MobileFF/usb2joy9/kicad/usb2mdjoy/usb2mdjoy.kicad_sch

## KiCad design kicad/usb2mdjoy/usb2mdjoy.kicad_sch (2026-10-20)

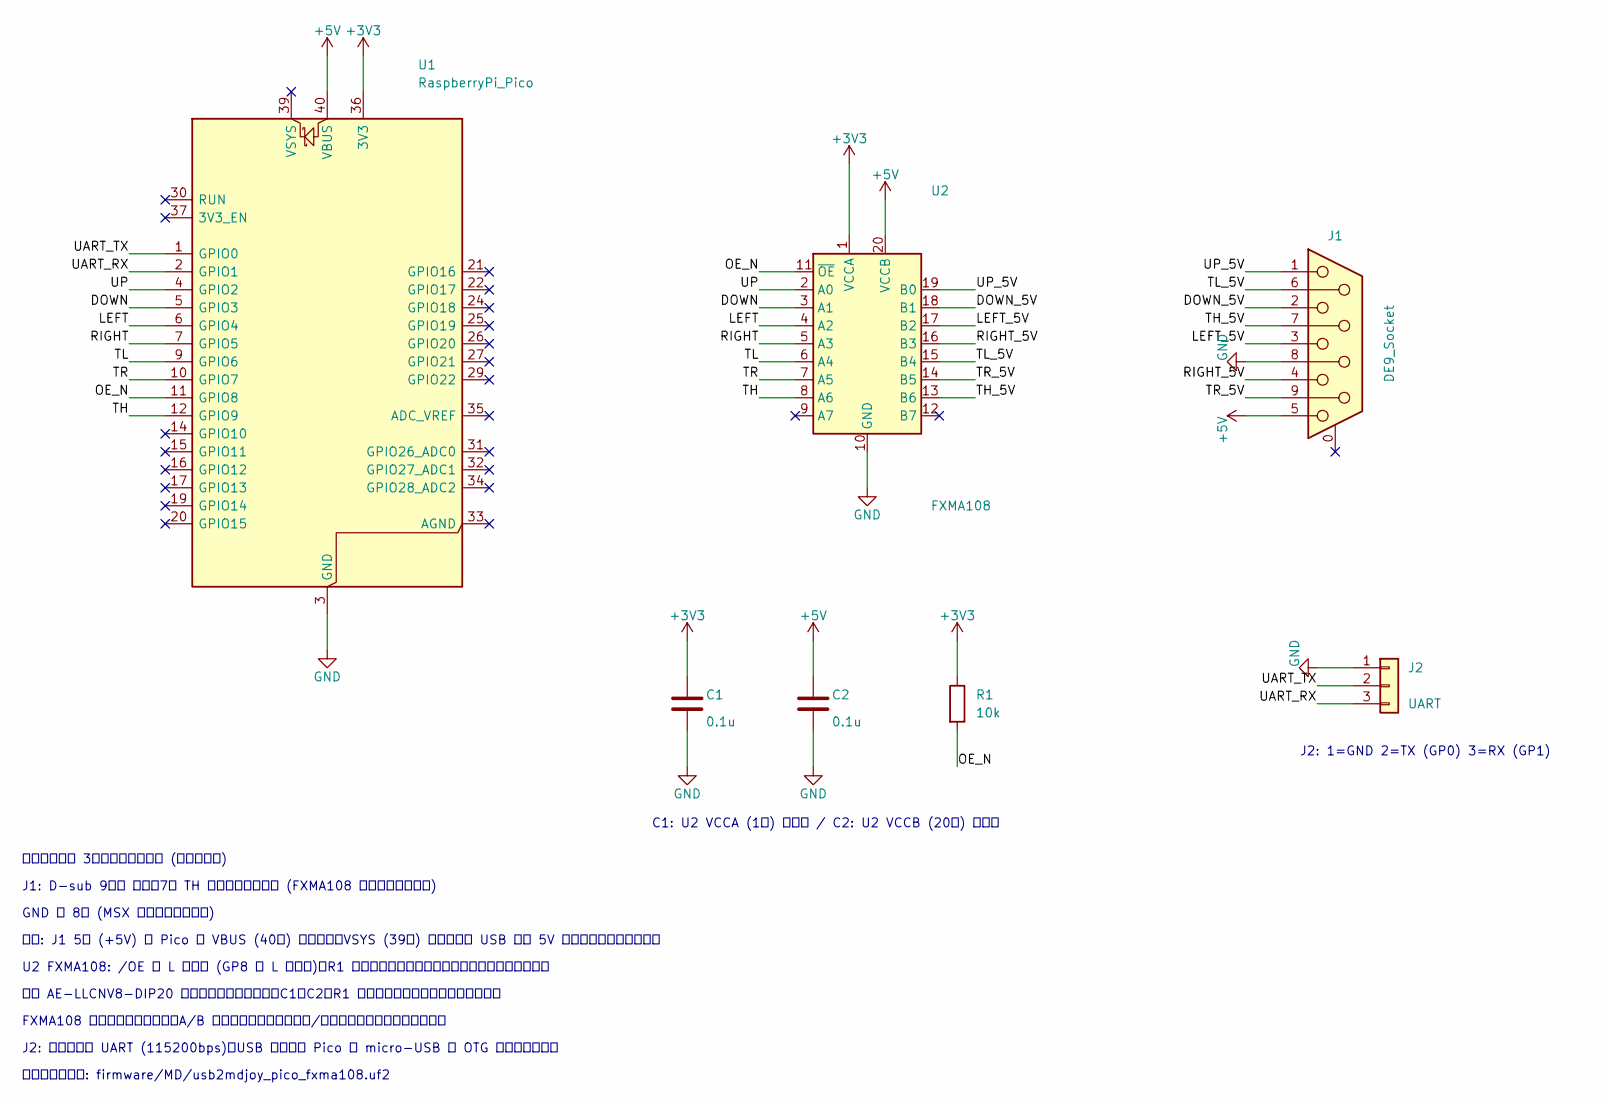
[picture p1: schematic usb2mdjoy.kicad_sch]

Parts:
C1, C2: 0.1u; C_0805_2012Metric
J1: DE9_Socket; DSUB-9_Socket_Horizontal_P2.77x2.84mm_EdgePinOffset7.70mm_H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
J2: UART; PinHeader_1x03_P2.54mm_Vertical
R1: 10k; R_0805_2012Metric
U1: RaspberryPi_Pico; RaspberryPi_Pico_Common_THT
U2: FXMA108; WQFN-20-1EP_2.5x4.5mm_P0.5mm_EP1x2.9mm

Connections:
+3V3: C1.1, R1.1, U1.36 (3V3), U2.1 (VCCA)
+5V: C2.1, J1.5, U1.40 (VBUS), U2.20 (VCCB)
DOWN: U1.5 (GPIO3), U2.3 (A1)
DOWN_5V: J1.2, U2.18 (B1)
GND: C1.2, C2.2, J1.8, J2.1, U1.3 (GND), U1.8 (GND), U1.13 (GND), U1.18 (GND), U1.23 (GND), U1.28 (GND), U1.38 (GND), U2.10 (GND)
LEFT: U1.6 (GPIO4), U2.4 (A2)
LEFT_5V: J1.3, U2.17 (B2)
OE_N: R1.2, U1.11 (GPIO8), U2.11 (~OE)
RIGHT: U1.7 (GPIO5), U2.5 (A3)
RIGHT_5V: J1.4, U2.16 (B3)
TH: U1.12 (GPIO9), U2.8 (A6)
TH_5V: J1.7, U2.13 (B6)
TL: U1.9 (GPIO6), U2.6 (A4)
TL_5V: J1.6, U2.15 (B4)
TR: U1.10 (GPIO7), U2.7 (A5)
TR_5V: J1.9, U2.14 (B5)
UART_RX: J2.3, U1.2 (GPIO1)
UART_TX: J2.2, U1.1 (GPIO0)
UP: U1.4 (GPIO2), U2.2 (A0)
UP_5V: J1.1, U2.19 (B0)

Notes on the sheet:
C1: U2 VCCA (1番) の近く / C2: U2 VCCB (20番) の近く
J2: 1=GND 2=TX (GP0) 3=RX (GP1)
メガドライブ 3ボタンパッド互換 (実機未確認)
J1: D-sub 9ピン メス。7番 TH は本体からの入力 (FXMA108 が向きを自動判別)
GND は 8番 (MSX 版とは配線が違う)
電源: J1 5番 (+5V) を Pico の VBUS (40番) に入れる。VSYS (39番) に入れると USB 側に 5V が出ずパッドが動かない
U2 FXMA108: /OE は L で有効 (GP8 が L を出力)。R1 は電源投入中に無効にしておくためのプルアップ
秋月 AE-LLCNV8-DIP20 モジュールを使う場合、C1・C2・R1 はモジュールに載っているので不要
FXMA108 はバスホールド付き。A/B 側の信号線にプルアップ/プルダウン抵抗を付けないこと
J2: デバッグ用 UART (115200bps)。USB パッドは Pico の micro-USB に OTG アダプタで接続
ファームウェア: firmware/MD/usb2mdjoy_pico_fxma108.uf2
