MobileFF/usb2joy9/(commit log)

2026-10-20 Initial commit: usb2joy9
    USB gamepad/keyboard to 9-pin joystick adapter for MSX and Mega Drive,
    using Raspberry Pi Pico (RP2040) USB host.
    - Firmware: usb2msxjoy (MSX) / usb2mdjoy (Mega Drive 3-button)
    - Button mapping stored in flash, edited with tools/config_gui
    - KiCad 9 schematics for the FXMA108 versions
    [usb2mdjoy.kicad_sch, usb2msxjoy.kicad_sch]
2026-10-20 Split firmware by target, note config-only UF2 in GUI
    - firmware/ split into firmware/MSX/ and firmware/MD/
    - Stop tracking firmware/pintest_pico.uf2 (debug-only; build from tools/pintest/)
    - Config GUI: show that the exported/written UF2 holds settings only
    - Docs: AE-LLCNV8-DIP20 module already has C1/C2/R1 on board
    [usb2mdjoy.kicad_sch, usb2msxjoy.kicad_sch]
